fckseng19/H-Bridge_Converter/Module H-Bridge/v4.jpeg

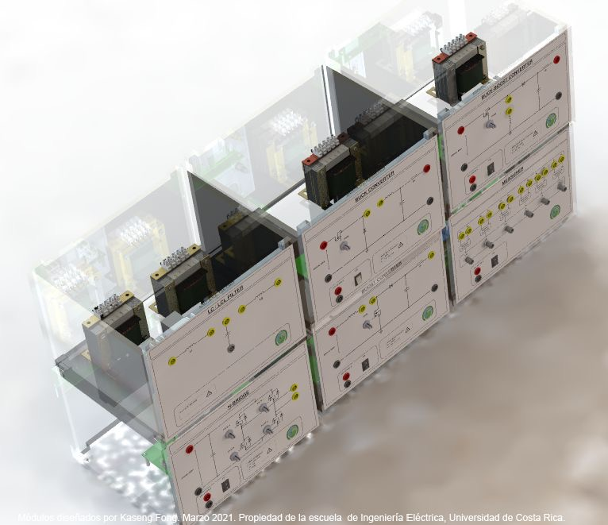
Module H-Bridge/v4.jpeg
