fckseng19/H-Bridge_Converter/Module H-Bridge/vista2.PNG

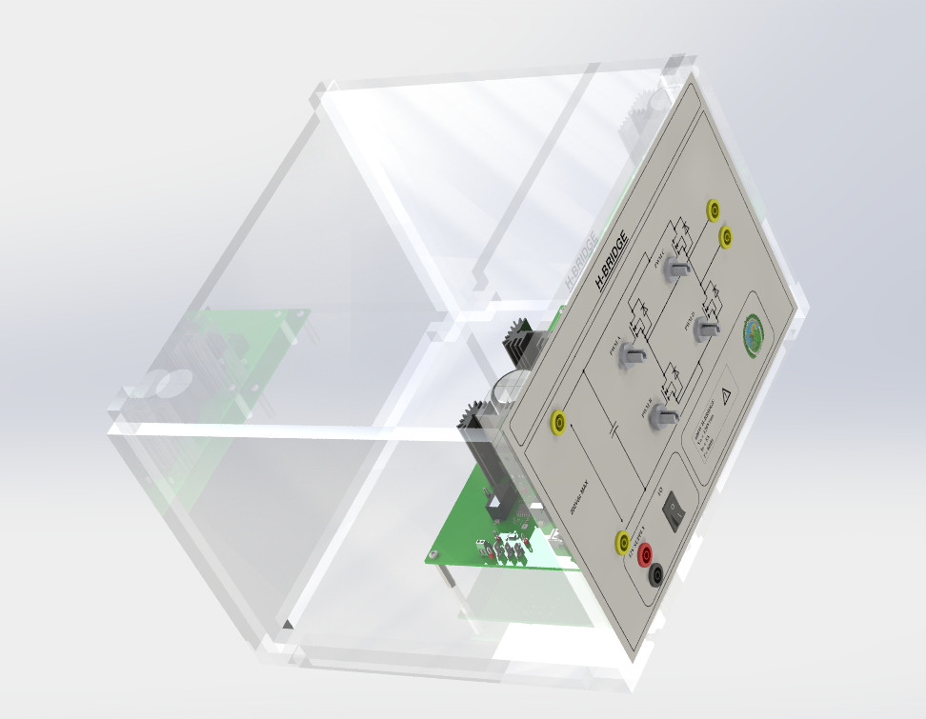
Module H-Bridge/vista2.PNG
