fckseng19/H-Bridge_Converter/README.md

# H-Bridge_Converter

Aquí se encuentran todas las simulaciones utilizadas en el diseño del convertidor BH-Bridge como también los archivos de las PCB,Gerber, Drill, Assambly, schematics, BOM, etc
