fckseng19/H-Bridge_Converter/LCL Module/LCL_frontal.PNG

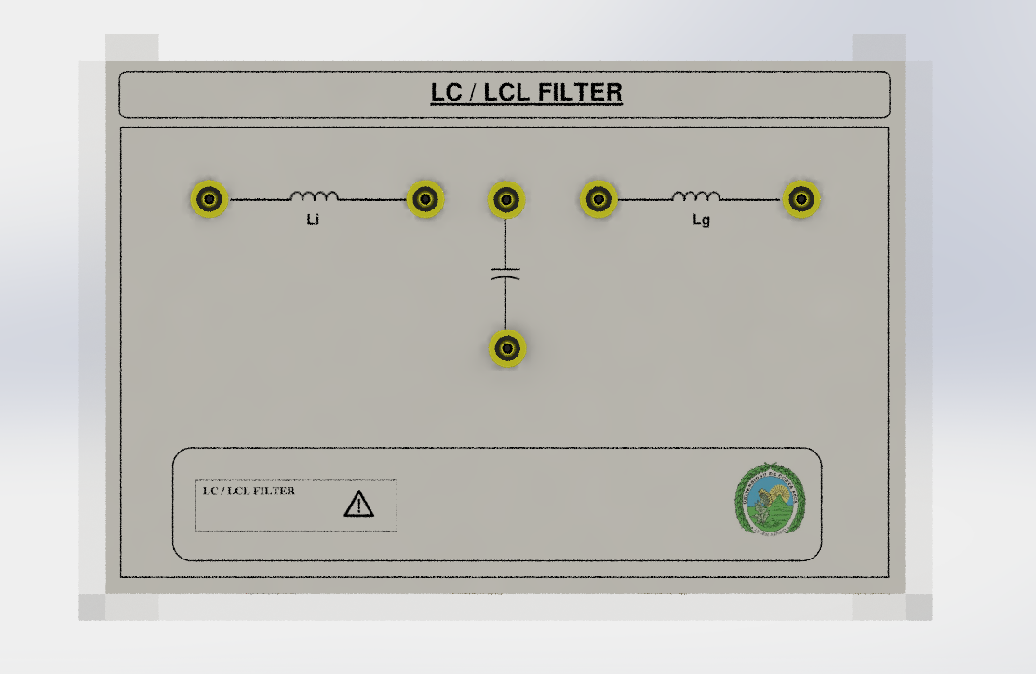
LCL Module/LCL_frontal.PNG
