fckseng19/H-Bridge_Converter/LCL Module/LCL_lateral.PNG

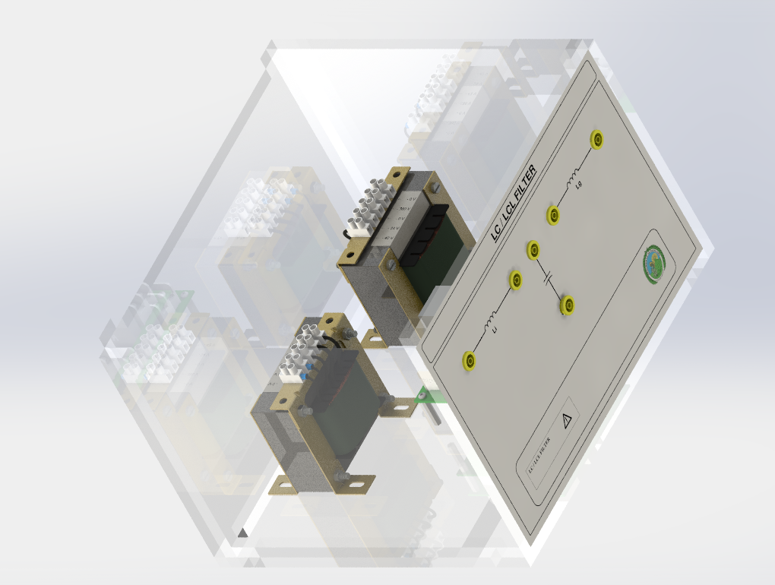
LCL Module/LCL_lateral.PNG
