fckseng19/H-Bridge_Converter/LCL Module/LCL_vista2.PNG

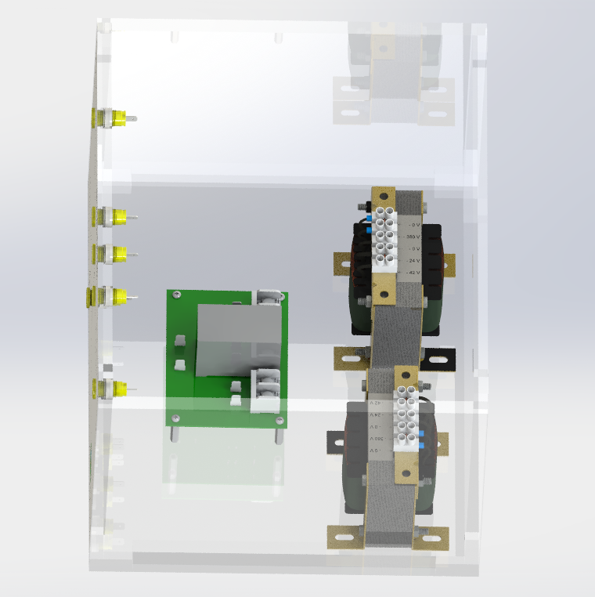
LCL Module/LCL_vista2.PNG
