fckseng19/H-Bridge_Converter/Module H-Bridge/Frontal.PNG

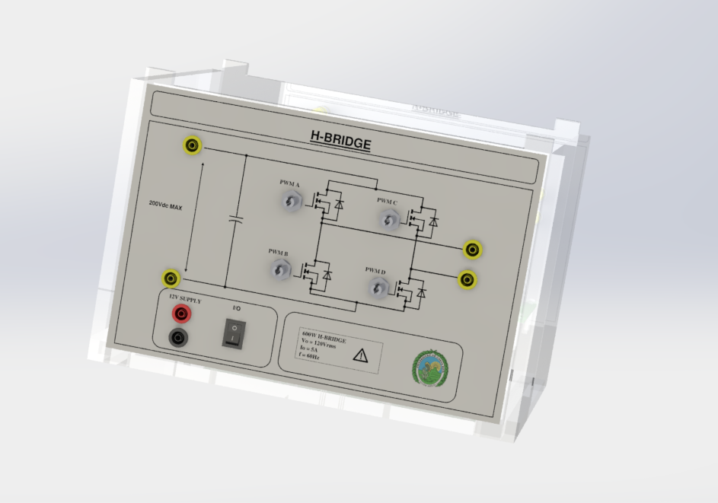
Module H-Bridge/Frontal.PNG
