fckseng19/H-Bridge_Converter/Module H-Bridge/lateral.PNG

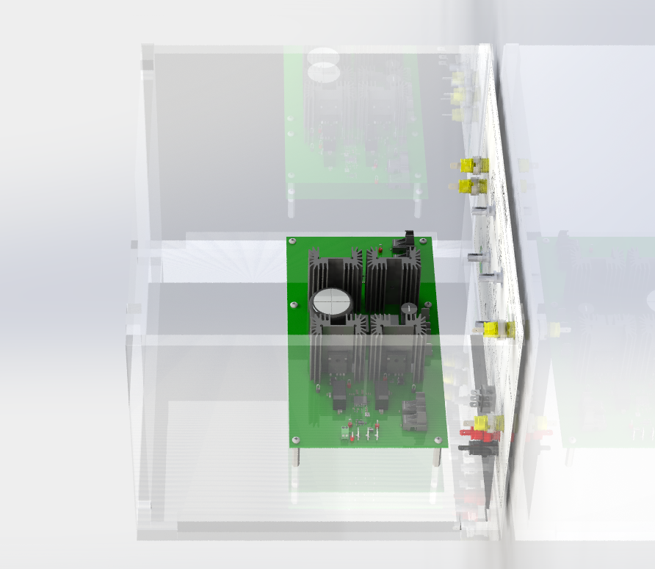
Module H-Bridge/lateral.PNG
