fckseng19/H-Bridge_Converter/Module H-Bridge/v1.jpeg

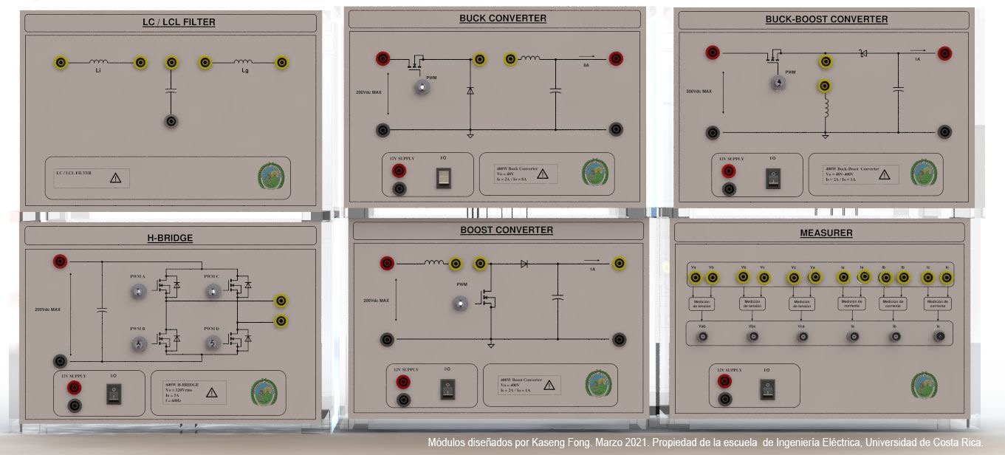
Module H-Bridge/v1.jpeg
