fckseng19/H-Bridge_Converter/Module H-Bridge/v2.jpeg

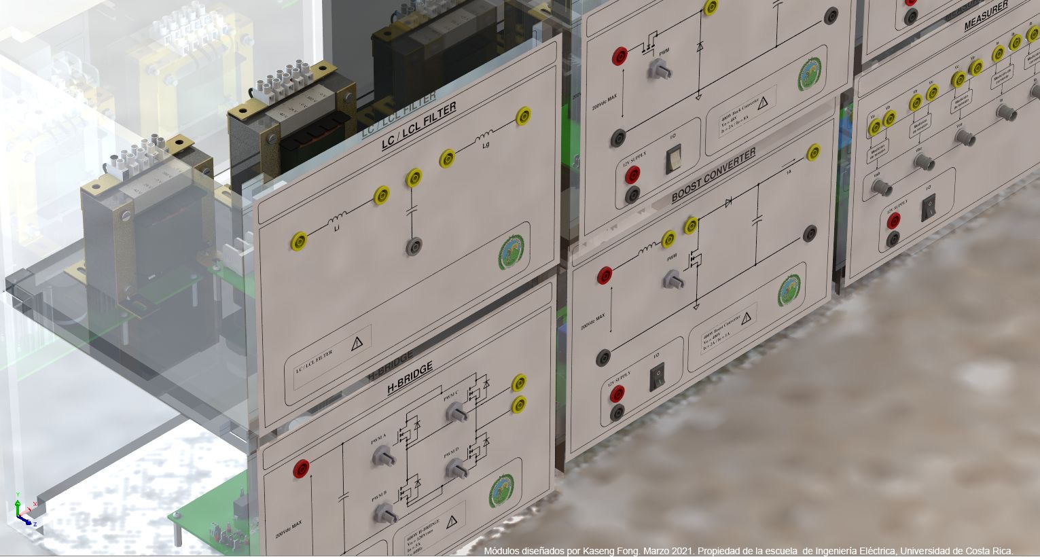
Module H-Bridge/v2.jpeg
