fckseng19/H-Bridge_Converter/Module H-Bridge/v3.jpeg

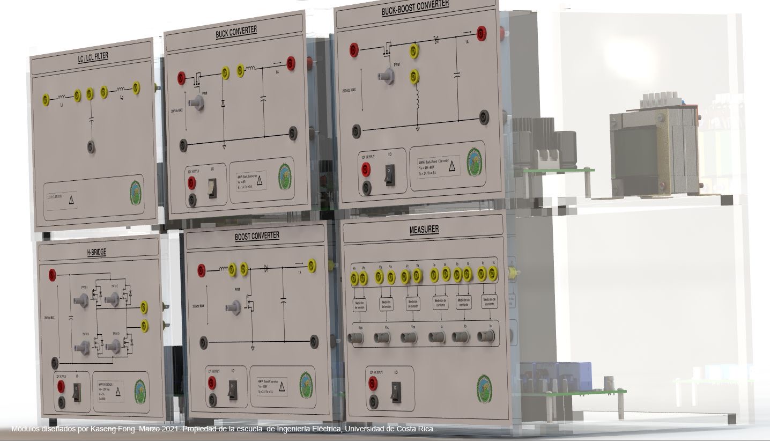
Module H-Bridge/v3.jpeg
