fckseng19/H-Bridge_Converter/Module H-Bridge/v5.jpeg

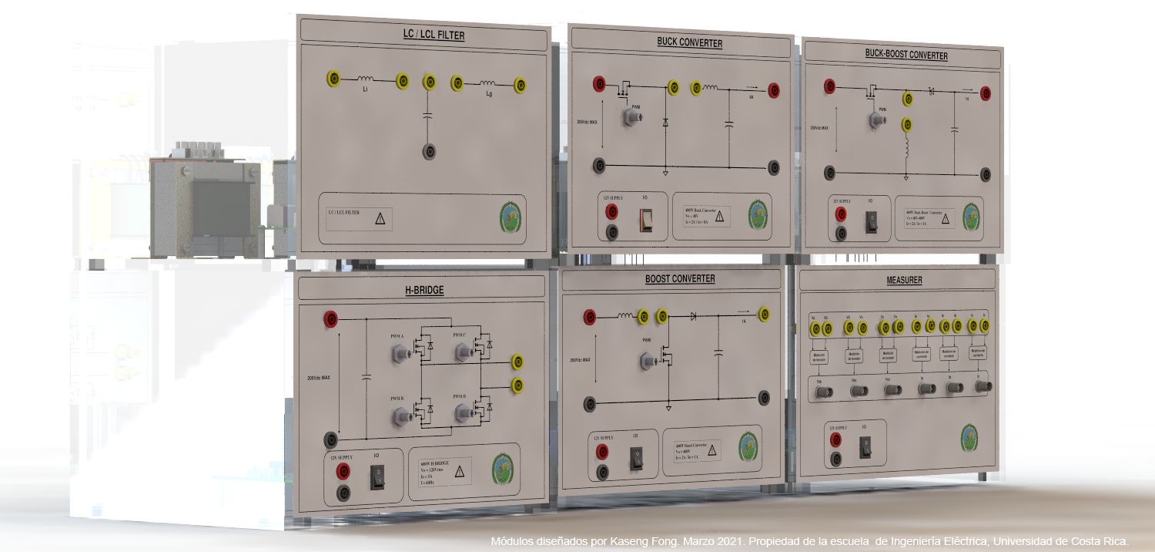
Module H-Bridge/v5.jpeg
