fckseng19/H-Bridge_Converter/Simulation/Gate Driver OrCAD Sim/GATE DRIVER FULLBRIDGE.png

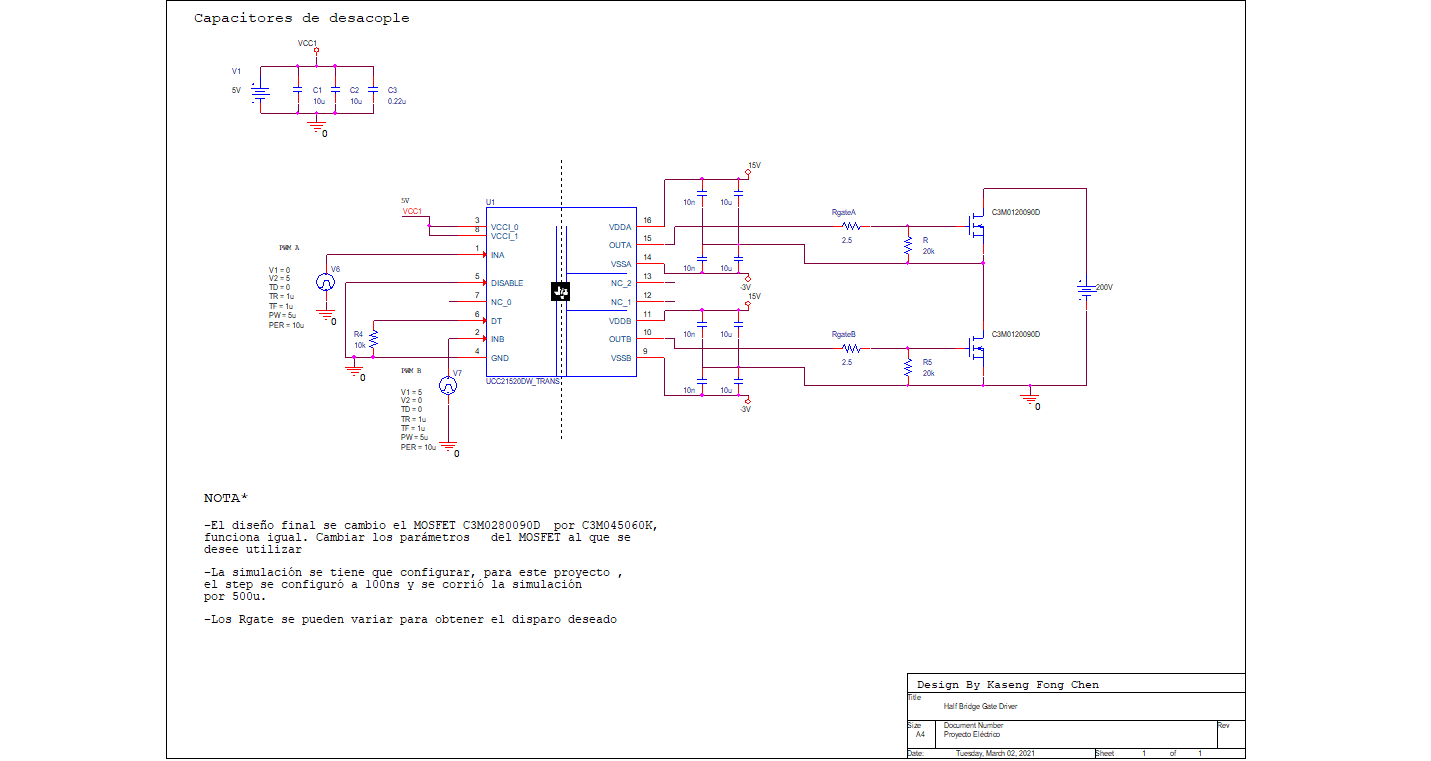
Simulation/Gate Driver OrCAD Sim/GATE DRIVER FULLBRIDGE.png
