fckseng19/H-Bridge_Converter/H_Bridge_Converter/LCL Filter/BOM.pdf

# Bill of Materials

Project Title: Bill of Materials for Project [LCL Filter.PrjPcb] (No PCB Document Selected)

### Project File Name: LCL Filter.PrjPcb Assembly Variant: None

Part Number | Description | Designator | Manufacture | Manufacture Part Number | Supplier | Supplier Part Number | Supplier Unit Price | Quantity
CT2238-0 | Cable Assembly 4MM Safety Jack, Panel W/.25 Fast on Terminal Black | Banana connector1 | Cal Test Electronics | CT2238-0 | Digi-Key | BKCT2238-0-ND | $2,00 | 1
CT2238-4 | Cable Assembly 4MM Safety Jack, Panel W/.25 Fast on Terminal Yellow | Banana connector2, Banana connector3, Banana connector4, Banana connector5, Banana connector6 | Cal Test Electronics | CT2238-0 | Digi-Key | BKCT2238-0-ND | $2,00 | 5
C4AF3BW5100A3MK | Cap Film 10uF 800V PP 10% (57.5 X 30 X 45mm) Radial 52.5mm 105°C Bulk | C1 | KEMET | C4AF3BW5100A3MK | Digi-Key | 399-17837-ND | $9,21 | 1
CMP-0003640-1 | Standoff, Hex,25mm Length, M3, Aluminum | H1, H2, H3, H4 | Keystone Electronics | 24438 | Digi-Key | 36-24438-ND | $0,68 | 4
CMP-0003646-1 | MACHINE SCREW PAN PHILLIPS M3 5mm | H5, H6, H7, H8 | Building Fasteners | MPMS 003 0005 PH | Digi-Key | H742-ND | | 4
62409-1 | Quick Disconnect Terminal M 15.8mm 7.5mm Tin Over Copper Automotive Bag | J1, J2, J3, J6, J7, J8 | TE Connectivity | 62409-1 | Newark | 26AC8417 | $0,17 | 6
8PCV-02-006 | Barrier Terminal Blocks VERTICAL RAISED 2P | J4, J5 | TE Connectivity | 8PCV-02-006 | Digi-Key | A98460-ND | $1,84 | 2
195M10 | Fixed Inductors CHOKE | L1 | Hammond Manufacturing | 195M10 | Digi-Key | HM2136-ND | $82,90 | 1
195J10 | Fixed Inductors CHOKE | L2 | Hammond Manufacturing | 195J10 | Digi-Key | HM2135-ND | $68,56 | 1
Total | $167,36 | | | | | | | 25
