fckseng19/H-Bridge_Converter/H_Bridge_Converter/LCL Filter/LCL Filter schematic.PDF

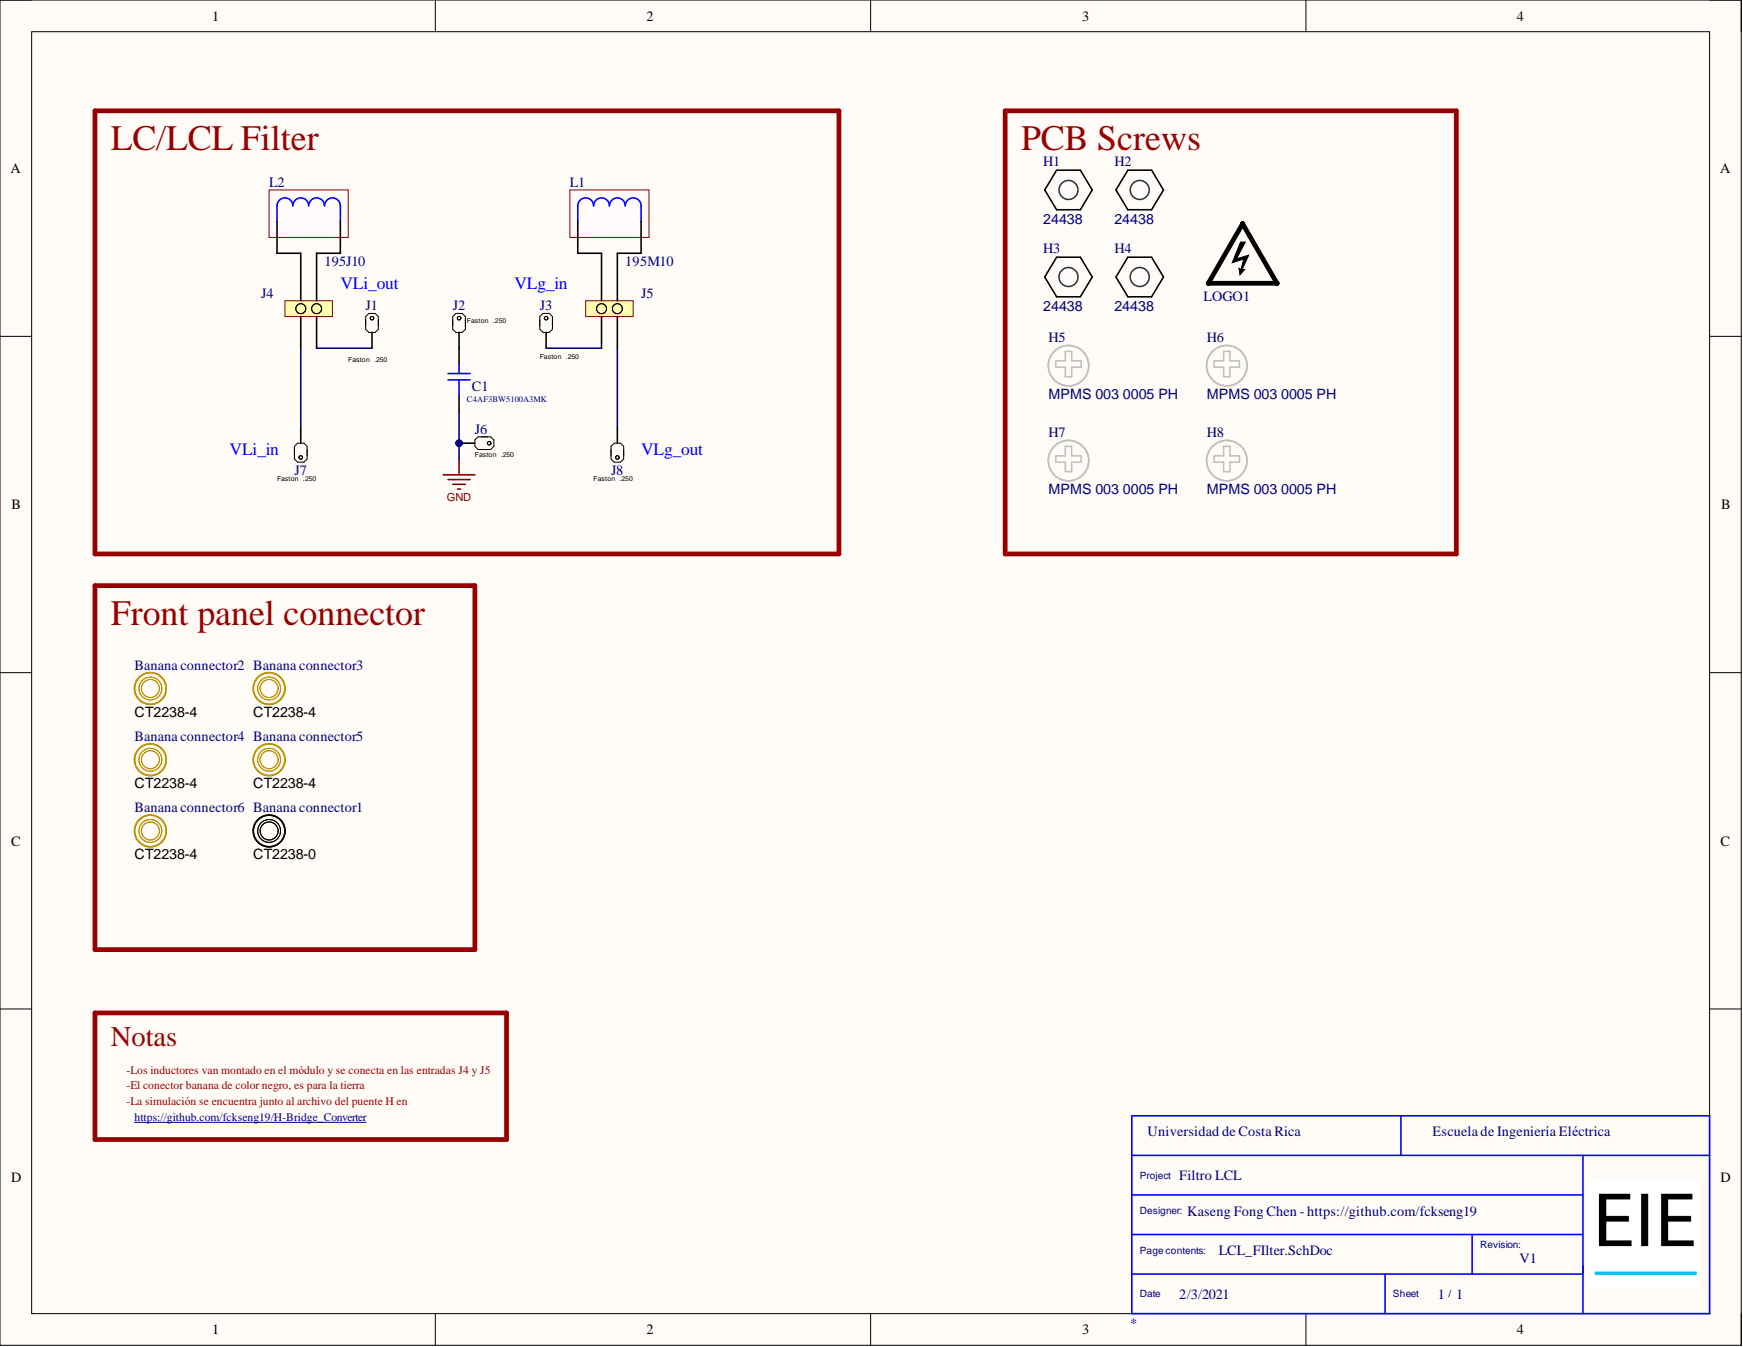
[picture p18: page 1]

-Los inductores van montado en el módulo y se conecta en las entradas J4 y J5
-El conector banana de color negro, es para la tierra
-La simulación se encuentra junto al archivo del puente H en
https://github.com/fckseng19/H-Bridge_Converter

Universidad de Costa Rica | Escuela de Ingeniería Eléctrica

Project Filtro LCL

Kaseng Fong Chen - https://github.com/fckseng19

LCL_FIlter.SchDoc | Revision: V1 Page contents:

Date 2/3/2021 | Sheet 1 / 1
