fckseng19/H-Bridge_Converter/(list of files, drawings)

Other design files:
H_Bridge_Converter/LCL Filter/LCL Filter.PrjPcb
H_Bridge_Converter/LCL Filter/LCL_Filter.PcbDoc
H_Bridge_Converter/LCL Filter/LCL_FIlter.SchDoc
PCB/Full_Bridge_Converter.PcbDoc
PCB/Full_Bridge_Converter.PrjPcb
PCB/Gate_Driver.SchDoc
PCB/Hardware.SchDoc
PCB/Optic_PWM.SchDoc
PCB/Power_Card.SchDoc
PCB/PowerSupply.SchDoc
Simulation/Gate Driver OrCAD Sim/GATE DRIVER FULLBRIDGE.DSN
Simulation/Gate Driver OrCAD Sim/Gate Driver FullBridge.opj
